denisosmani/energy_meter/(list of files, drawings)

Other design files:
Energy_Meter_Proteus_v8.11/Energymeter.pdsprj
